Rudd-O/prusa-mk4-smart-enclosure/KiCad electrical design/Parts/MP1584EN LM2596.jpg

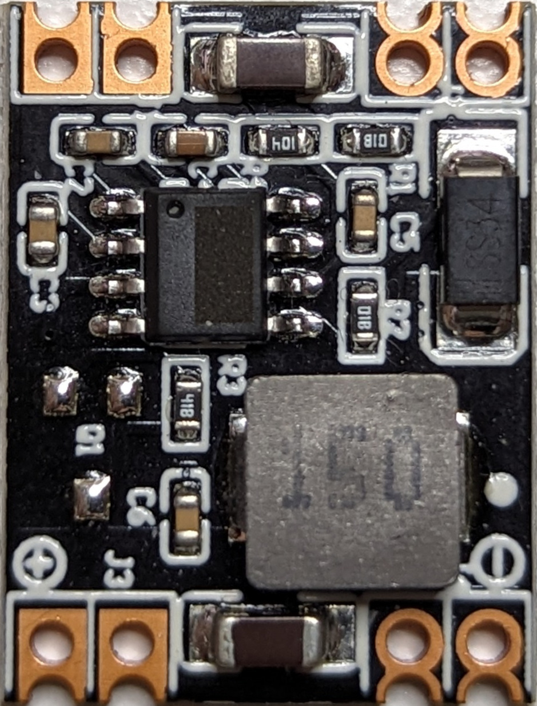
KiCad electrical design/Parts/MP1584EN LM2596.jpg
