Rudd-O/prusa-mk4-smart-enclosure/README.md

# Prusa MK4 smart enclosure

This project contains files and information for the Prusa MK4 smart enclosure,
documented [in its own guide](https://rudd-o.com/smk4e).
