Rudd-O/prusa-mk4-smart-enclosure/3D models/Prusa MK4 smart enclosure electronics case-Upper cover.step

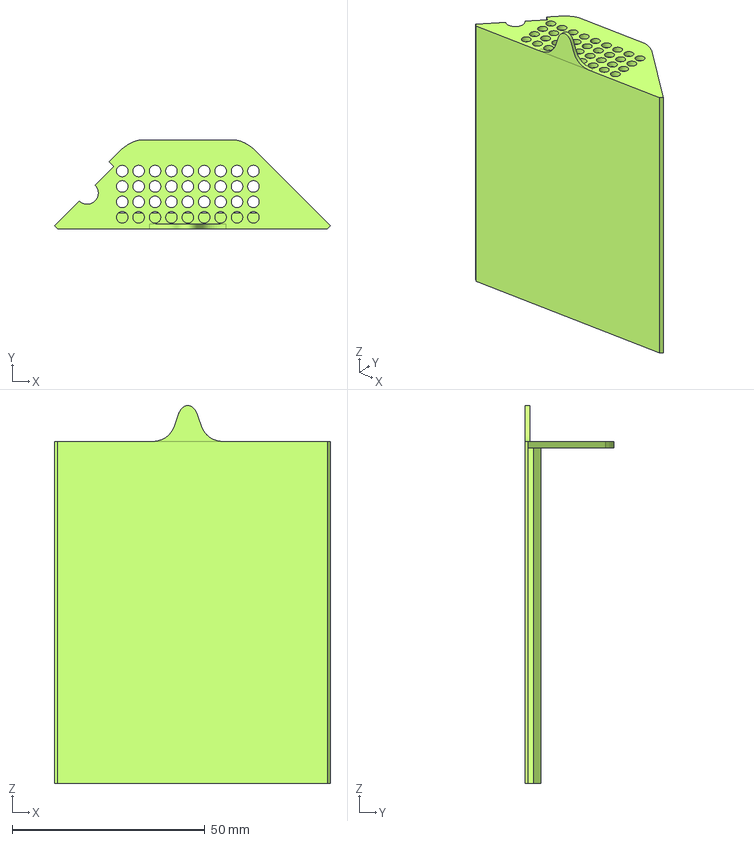
[picture p2: CAD file, 2026-03-29]
3D models/Prusa MK4 smart enclosure electronics case-Upper cover.step
71.6 x 23.0 x 98.0 mm
