Rudd-O/prusa-mk4-smart-enclosure/3D models/Prusa MK4 smart enclosure electronics case.FCStd

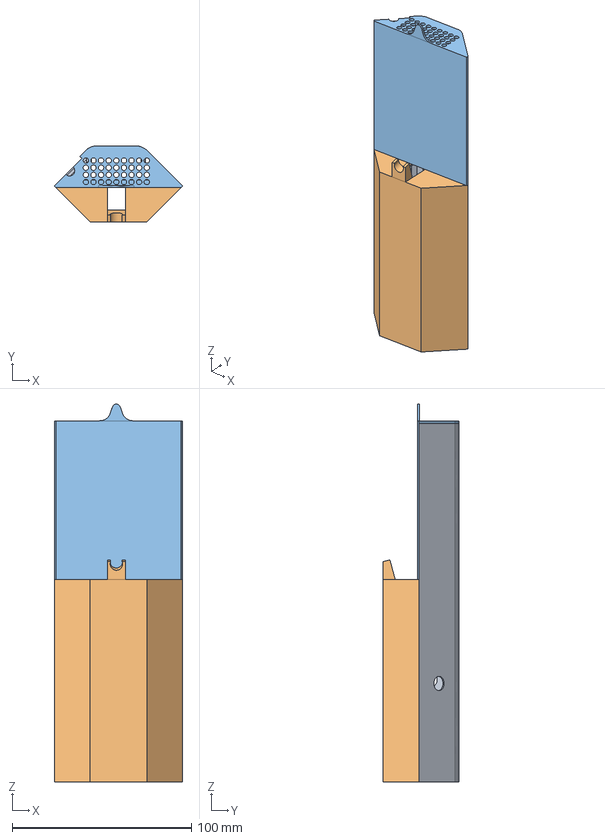
[picture p3: CAD file, 2026-03-29]
3D models/Prusa MK4 smart enclosure electronics case.FCStd
71.6 x 42.2 x 211.0 mm
Electronics holder
Lower cover
Upper cover
