Rudd-O/prusa-mk4-smart-enclosure/3D models/Prusa MK4 smart enclosure electronics case-Lower cover.step

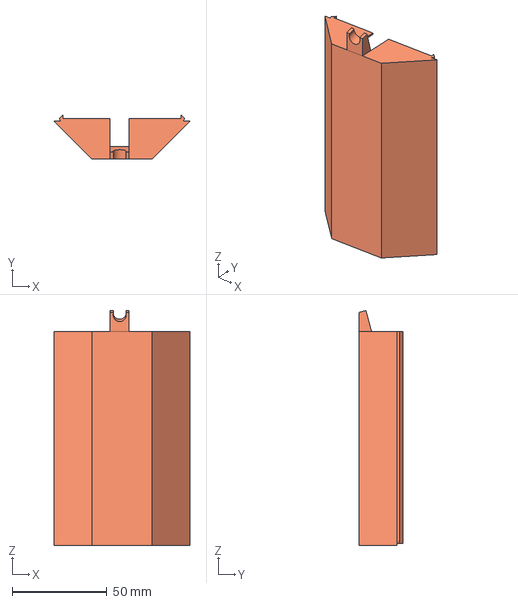
[picture p4: CAD file, 2026-03-29]
3D models/Prusa MK4 smart enclosure electronics case-Lower cover.step
71.6 x 23.4 x 124.0 mm
