Rudd-O/prusa-mk4-smart-enclosure/3D models/Prusa MK4 smart enclosure electronics case-Electronics holder.step

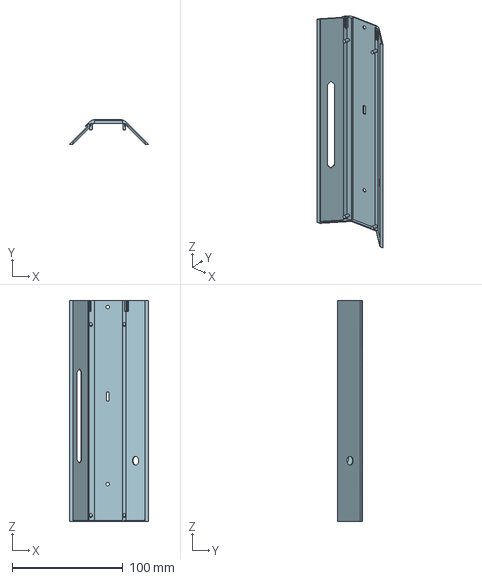
[picture p5: CAD file, 2026-03-29]
3D models/Prusa MK4 smart enclosure electronics case-Electronics holder.step
71.6 x 22.2 x 200.0 mm
