Rudd-O/prusa-mk4-smart-enclosure/3D models/(From Prusa) Basic-board+PSU-Delta-Set.3mf

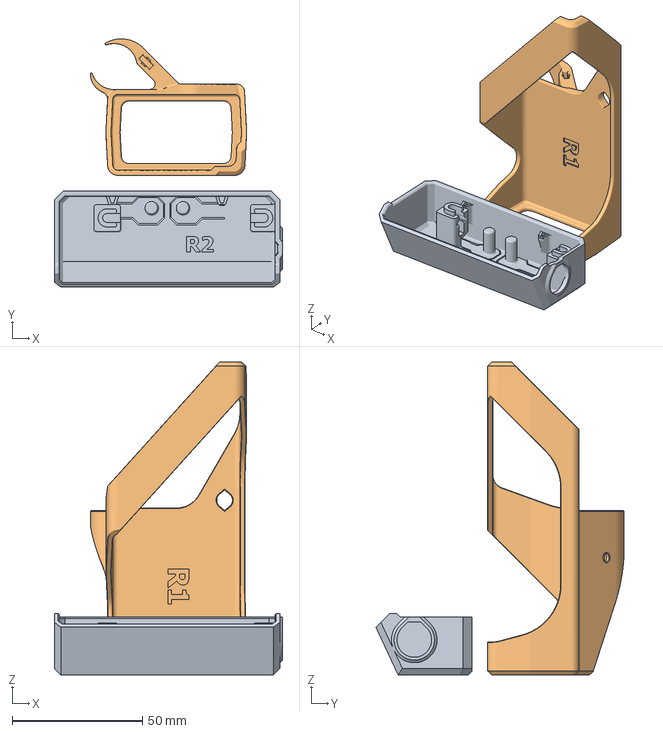
[picture p6: CAD file, 2024-04-30]
3D models/(From Prusa) Basic-board+PSU-Delta-Set.3mf
87.6 x 95.2 x 120.0 mm
Basic-board-cover.stl
External-PSU-bracket-DELTA.stl
