Rudd-O/prusa-mk4-smart-enclosure/3D models/Prusa MK4 smart enclosure BME688 sensor pocket holder.FCStd

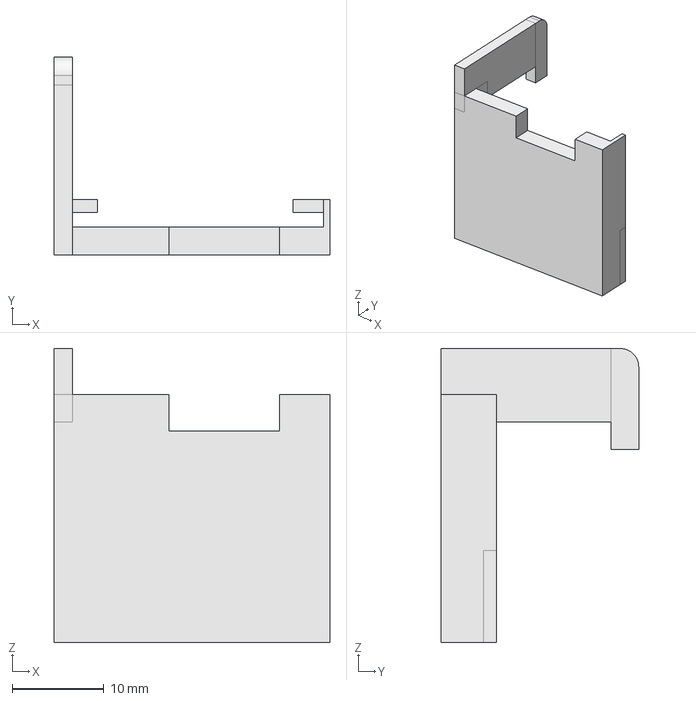
[picture p7: CAD file, 2024-04-30]
3D models/Prusa MK4 smart enclosure BME688 sensor pocket holder.FCStd
30.0 x 21.5 x 32.0 mm
