Rudd-O/prusa-mk4-smart-enclosure/(list of files, cad)

Other CAD files:
3D models/Prusa MK4 smart enclosure BME688 sensor pocket holder.3mf
3D models/Prusa MK4 smart enclosure electronics case.3mf
