Rudd-O/prusa-mk4-smart-enclosure/KiCad electrical design/Prusa MK4 smart enclosure.kicad_pcb

## KiCad design KiCad electrical design/Prusa MK4 smart enclosure.kicad_pcb (2024-04-30)

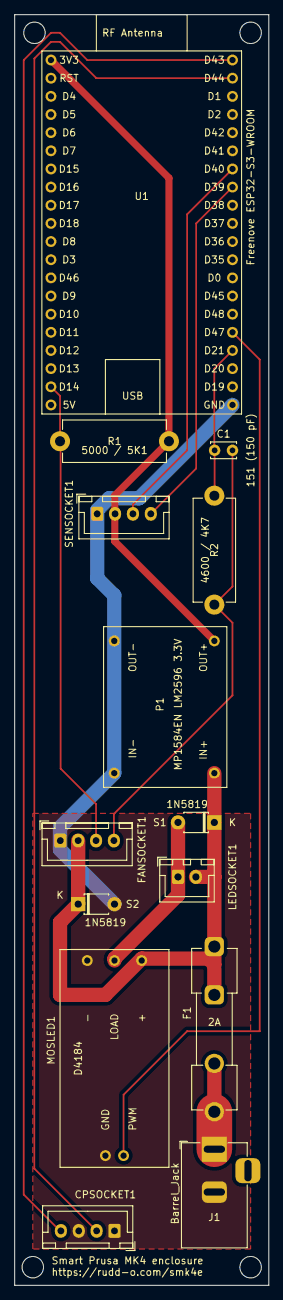
[picture p8: board Prusa MK4 smart enclosure.kicad_pcb from above]

Board: 2 copper layers, 35.6 x 177.8 mm, 14 parts (0 on the bottom side), 13 nets.

Parts:
C1: 151 (150 pF); C_Disc_D3.4mm_W2.1mm_P2.50mm
CPSOCKET1: PINHD_1x4_Female; JST_XH_B4B-XH-A_1x04_P2.50mm_Vertical
F1: 2A; Fuseholder_Clip-5x20mm_Keystone_3517_Inline_P23.11x6.76mm_D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
FANSOCKET1: PINHD_1x4_Female; JST_XH_B4B-XH-A_1x04_P2.50mm_Vertical
J1: Barrel_Jack; BarrelJack_Horizontal
LEDSOCKET1: PINHD_1x2_Female; JST_XH_B2B-XH-A_1x02_P2.50mm_Vertical
MOSLED1: D4184; D4184 MOSFET control module
P1: MP1584EN LM2596 3.3V; MP1584EN LM2596
R1: 5000 / 5K1; R_Axial_DIN0614_L14.3mm_D5.7mm_P15.24mm_Horizontal
R2: 4600 / 4K7; R_Axial_DIN0614_L14.3mm_D5.7mm_P15.24mm_Horizontal
S1, S2: 1N5819; D_T-1_P5.08mm_Horizontal
SENSOCKET1: PINHD_1x4_Female; JST_XH_B4B-XH-A_1x04_P2.50mm_Vertical
U1: Freenove ESP32-S3-WROOM

Connections:
+3.3V: P1.3 (OUT), R1.2, SENSOCKET1.2, U1.2 (3V3)
+24V: F1.1, FANSOCKET1.2, LEDSOCKET1.2, MOSLED1.1 (+), P1.1 (IN), S1.1 (K), S2.1 (K)
GND: CPSOCKET1.1, CPSOCKET1.3, FANSOCKET1.1, J1.2, MOSLED1.3 (-), MOSLED1.5 (GND), P1.2 (GND), S2.2 (A), SENSOCKET1.1, U1.44 (GND)
unnamed: F1.2, J1.1
unnamed: MOSLED1.4 (PWM), U1.28 (GPIO47)
unnamed: SENSOCKET1.4, U1.36 (GPIO39/MTCK)
unnamed: SENSOCKET1.3, U1.37 (GPIO40/MTDO)
VDD: LEDSOCKET1.1, MOSLED1.2 (LOAD), S1.2 (A)
fan_pwm: C1.2, FANSOCKET1.4, R2.2
fan_pwm_filtered: C1.1, R2.1, U1.27 (GPIO21)
filt_toggle: CPSOCKET1.2, U1.42 (GPIO44/U0RXD)
led_toggle: CPSOCKET1.4, U1.43 (GPIO43/U0TXD)
pulse_counter: FANSOCKET1.3, R1.1, U1.20 (GPIO14/ADC2_CH3)
