Rudd-O/prusa-mk4-smart-enclosure/(commit log)

2024-04-30 Add KiCad files.
    [Prusa MK4 smart enclosure-B_Cu.gbl, Prusa MK4 smart enclosure-B_Mask.gbs, Prusa MK4 smart enclosure-B_Silkscreen.gbo, Prusa MK4 smart enclosure-Edge_Cuts.gm1, Prusa MK4 smart enclosure-F_Cu.gtl, Prusa MK4 smart enclosure-F_Mask.gts, Prusa MK4 smart enclosure-F_Silkscreen.gto, Prusa MK4 smart enclosure-NPTH-drl_map.gbr]
2024-04-30 Add 3MF and FreeCad files.
    [(From Prusa) Basic-board+PSU-Delta-Set.3mf, Prusa MK4 smart enclosure BME688 sensor pocket holder.3mf, Prusa MK4 smart enclosure BME688 sensor pocket holder.FCStd, Prusa MK4 smart enclosure electronics case.3mf, Prusa MK4 smart enclosure electronics case.FCStd]
2024-05-01 Disable camera frame rate by default.
2024-05-01 Make camera react faster.
2024-05-04 Cover case of homeassistant sensor.
2024-07-03 Update prusa-mk4-smart-enclosure.yaml for 2024.6.6 ESPHome
    neffs' PR is still not merged, but it has been updated.
2024-09-03 Add free heap sensor, commented.
2024-10-08 No longer necessary to include the patch for BME688.
    [prusa-mk4-smart-enclosure.yaml]
2026-03-29 Version 1.1.
    [Prusa MK4 smart enclosure electronics case-Electronics holder.step, Prusa MK4 smart enclosure electronics case-Lower cover.step, Prusa MK4 smart enclosure electronics case-Upper cover.step, Prusa MK4 smart enclosure electronics case.3mf, Prusa MK4 smart enclosure electronics case.FCStd]
