Rudd-O/prusa-mk4-smart-enclosure/(notices)

Notices in the files:
KiCad electrical design/Prusa MK4 smart enclosure.kicad_sch:
License: https://creativecommons.org/licenses/by-nc/4.0
